quilofucar-web/Temp_TH_tester_wemos/docs/img/tira_bus_3.png

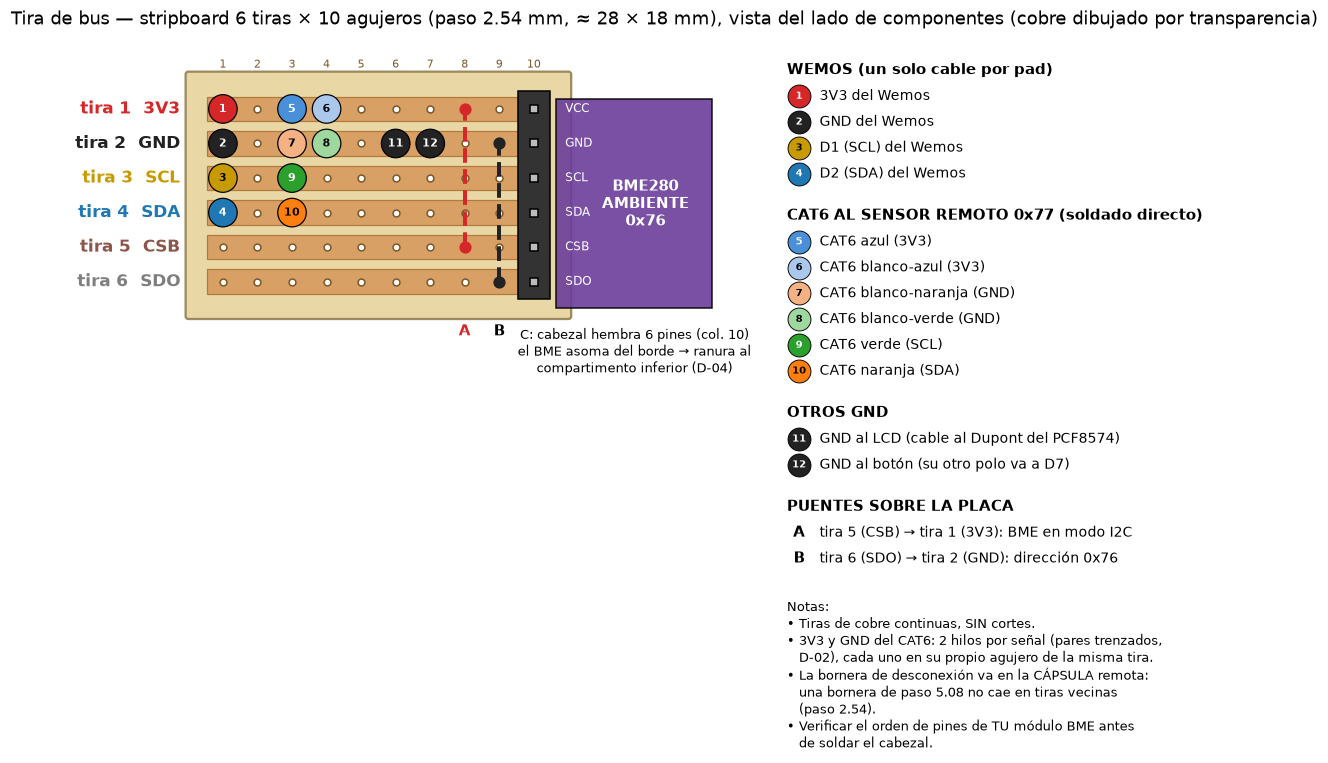
docs/img/tira_bus_3.png
