quilofucar-web/Temp_TH_tester_wemos/output/ensamble_16.step

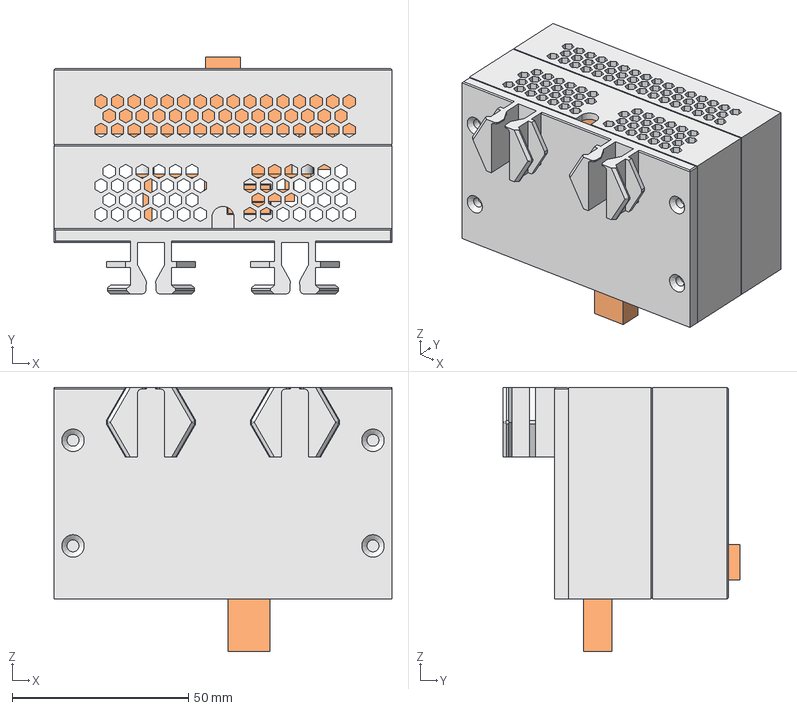
[picture p4: CAD file, 2026-10-19]
output/ensamble_16.step
96.0 x 67.3 x 75.0 mm
tapa_trasera
caja_trasera
caja_delantera
env_placa
env_wemos
env_pines_wemos
env_cabezal_bme
env_cable_usb
env_lcd
env_cable_lcd
env_boton
env_bme
