quilofucar-web/Temp_TH_tester_wemos/externalfiles/3mfs/tapa_trasera_prueba_3.3mf

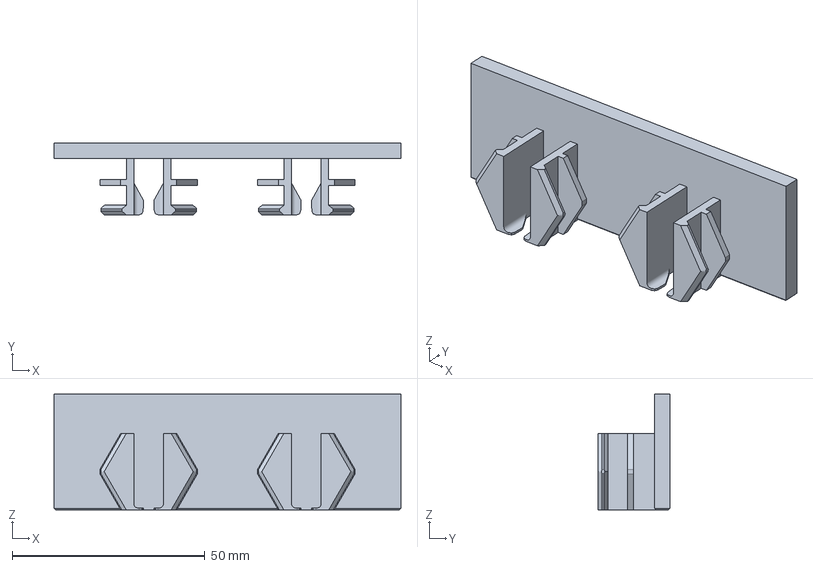
[picture p5: CAD file, 2026-10-19]
externalfiles/3mfs/tapa_trasera_prueba_3.3mf
90.0 x 18.6 x 30.0 mm
