quilofucar-web/Temp_TH_tester_wemos/externalfiles/3mfs/carcasa_completa_1.3mf

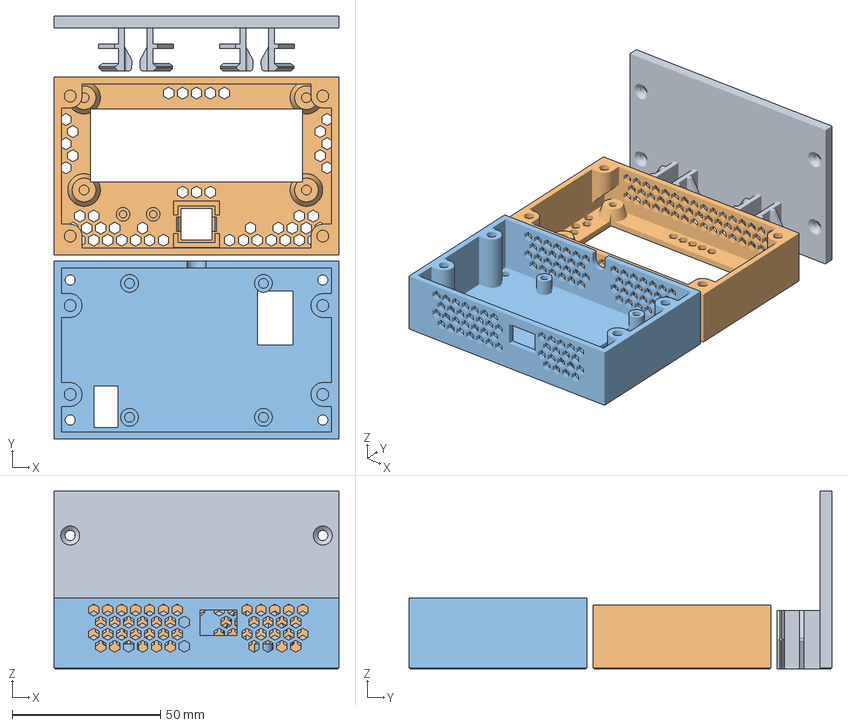
[picture p6: CAD file, 2026-10-19]
externalfiles/3mfs/carcasa_completa_1.3mf
96.0 x 142.7 x 60.0 mm
tapa_trasera_3.stl
caja_delantera_6.stl
caja_trasera_4.stl
