quilofucar-web/Temp_TH_tester_wemos/(list of files, cad)

Other CAD files:
externalfiles/3mfs/tapa_trasera_prueba_3.gcode.3mf
