quilofucar-web/Temp_TH_tester_wemos/(commit log)

2026-10-19 Monitor de temperatura y humedad para pared HSW (Wemos D1 mini + ESPHome)
    Carcasa en CadQuery (3 piezas en PETG), firmware ESPHome v2, documentacion de diseno y bitacora del proyecto. El detalle dia por dia esta en docs/bitacora.md.
    [carcasa_completa_1.3mf, ensamble_16.step, tapa_trasera_prueba_3.3mf, tapa_trasera_prueba_3.gcode.3mf]
2026-10-19 docs: CLAUDE.md con el repo publico y la rama de respaldo local
2026-10-19 docs: cierre de sesion 2026-10-19 (repo publico)
    - bitacora: revision para publicar, historial nuevo, STL de terceros fuera, licencia MIT (D-38 a D-40)
    - CLAUDE.md: decisiones, LICENSE y notas del conector
2026-10-24 CLAUDE.md: cerrados fecha y hora de la v2 y el LED del PCF8574
    Claude-Session: https://claude.ai/code/session_01KFz1N6UhkKoHXuXHot9N2o
2026-10-27 docs: fotos del medidor montado en la pared HSW
    Cierra el último pendiente de la carcasa: 2 fotos (luz encendida y apagada)
    en el README, reducidas a 1600 px y sin metadatos EXIF.
    Claude-Session: https://claude.ai/code/session_01USbmZNdZ8uXhXfAmP9aQrh
